FurkanTahaBademci/Tasarim_Kodlar_Elektromanyetik_Katapult/README.md

# Tasarim_Kodlar_Elektromanyetik_Katapult
