FurkanTahaBademci/Tasarim_Kodlar_Elektromanyetik_Katapult/Final Tasarım CAD/Teknik Resim.PNG

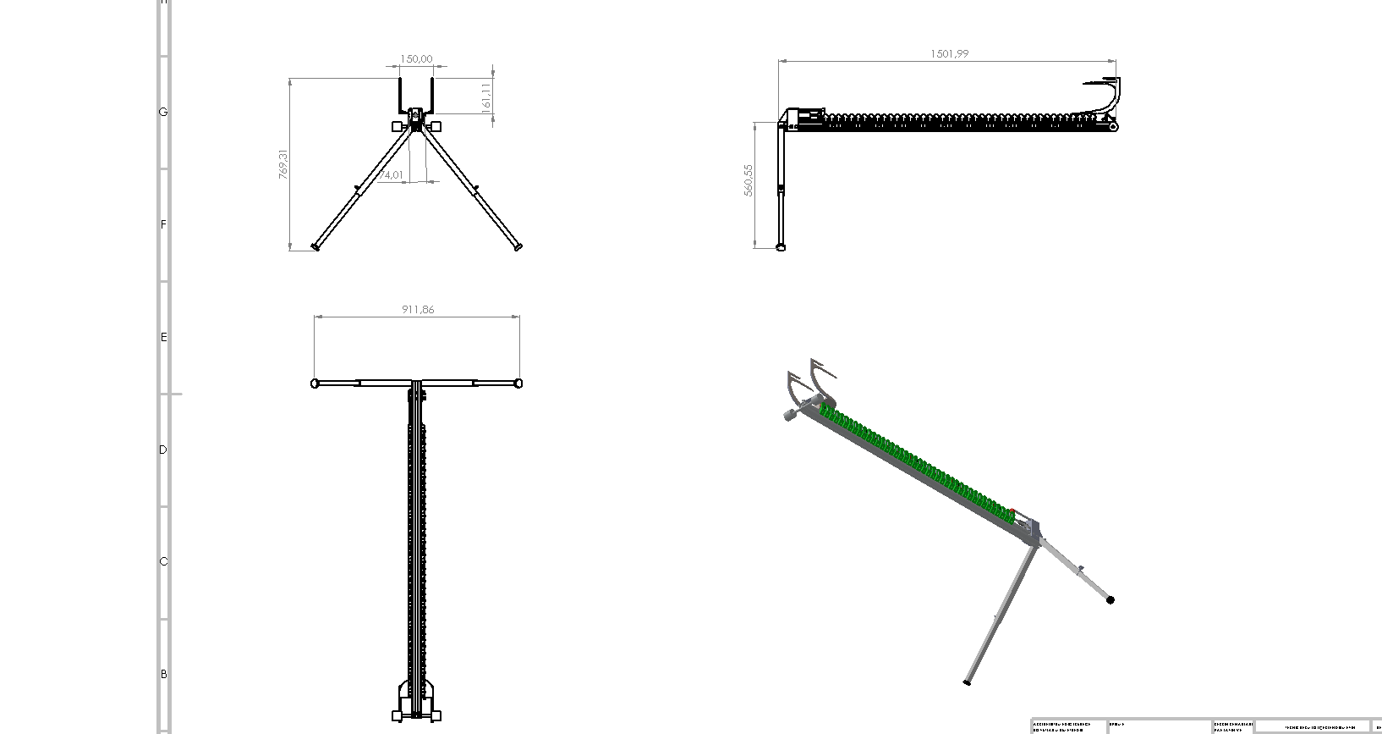
Final Tasarım CAD/Teknik Resim.PNG
