FurkanTahaBademci/Tasarim_Kodlar_Elektromanyetik_Katapult/Final Tasarım CAD/Kızak.sldasm

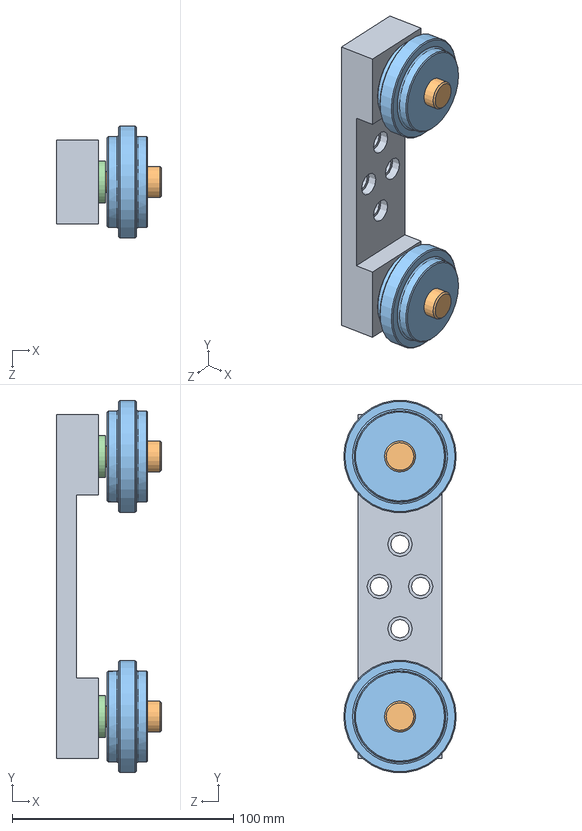
[picture p41: CAD file, 2025-01-13]
Final Tasarım CAD/Kızak.sldasm
47.6 x 168.0 x 50.8 mm
2757-1_b
2290_b x 2
2290_w x 2
2290_p2 x 2
