FurkanTahaBademci/Tasarim_Kodlar_Elektromanyetik_Katapult/Final Tasarım CAD/Bütünleşik Montaj.SLDASM

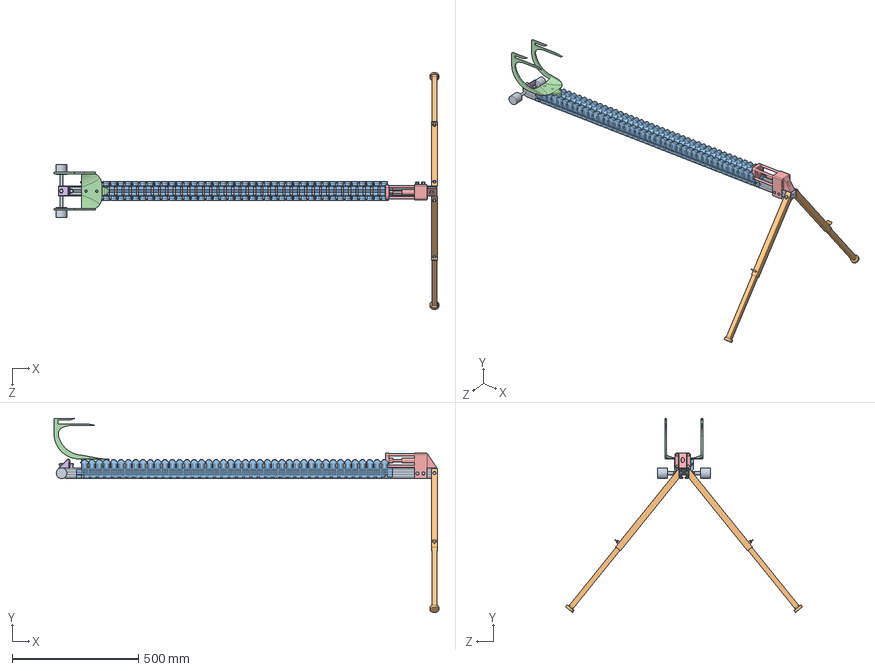
[picture p42: CAD file, 2025-01-13]
Final Tasarım CAD/Bütünleşik Montaj.SLDASM
1526.4 x 769.3 x 940.2 mm
Sigma Profil Ray
Teleskobik Ayak x 2
Bobin ve Bobin Yuvası x 84
Taşıma Platformu
Darbe Emici
optik_sensörü
