FurkanTahaBademci/Tasarim_Kodlar_Elektromanyetik_Katapult/Final Tasarım CAD/Sigma Profil Ray.SLDPRT

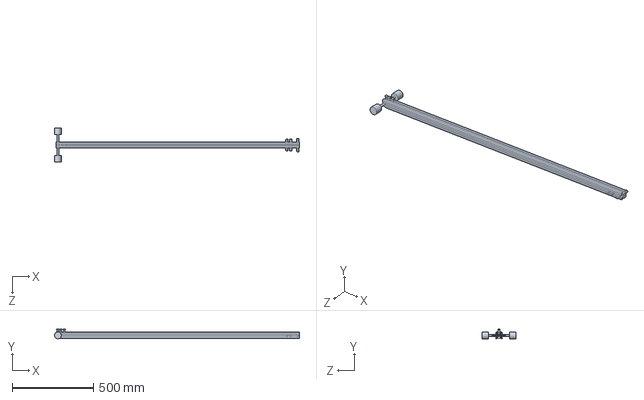
[picture p43: CAD file, 2025-01-13]
Final Tasarım CAD/Sigma Profil Ray.SLDPRT
1509.9 x 59.1 x 212.0 mm
