FurkanTahaBademci/Tasarim_Kodlar_Elektromanyetik_Katapult/Final Tasarım CAD/Taşıma Platformu.SLDPRT

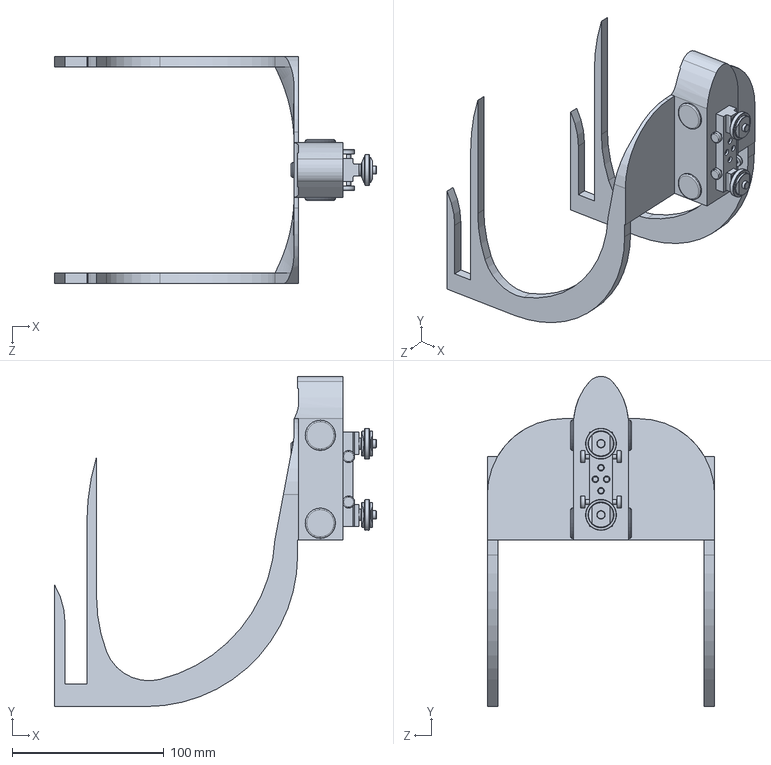
[picture p44: CAD file, 2025-01-13]
Final Tasarım CAD/Taşıma Platformu.SLDPRT
212.5 x 217.9 x 150.0 mm
