FurkanTahaBademci/Tasarim_Kodlar_Elektromanyetik_Katapult/Final Tasarım CAD/optik_sensörü.SLDPRT

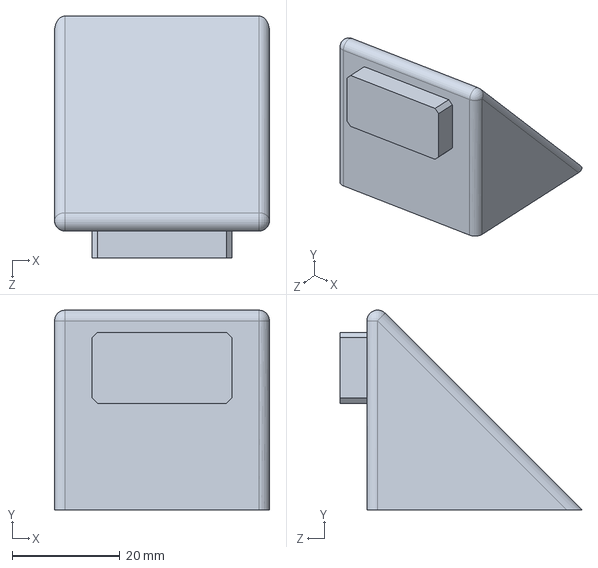
[picture p45: CAD file, 2025-01-13]
Final Tasarım CAD/optik_sensörü.SLDPRT
40.0 x 37.2 x 45.0 mm
