FurkanTahaBademci/Tasarim_Kodlar_Elektromanyetik_Katapult/Final Tasarım CAD/Teleskobik Ayak.SLDPRT

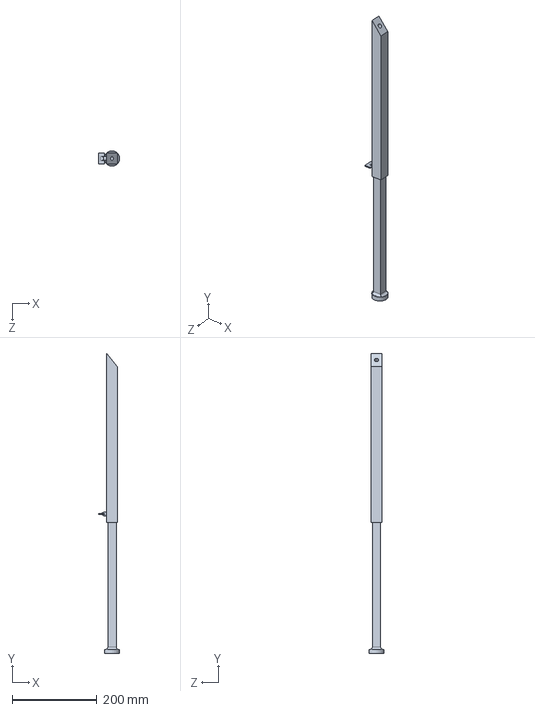
[picture p46: CAD file, 2025-01-13]
Final Tasarım CAD/Teleskobik Ayak.SLDPRT
50.7 x 710.0 x 36.3 mm
