FurkanTahaBademci/Tasarim_Kodlar_Elektromanyetik_Katapult/Final Tasarım CAD/Bobin ve Bobin Yuvası.SLDPRT

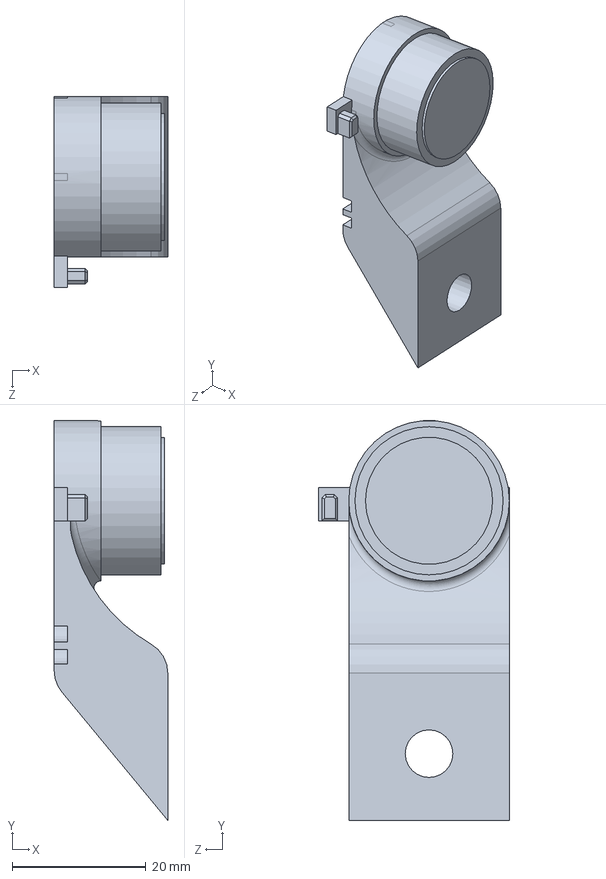
[picture p47: CAD file, 2025-01-13]
Final Tasarım CAD/Bobin ve Bobin Yuvası.SLDPRT
17.0 x 59.8 x 28.5 mm
