FurkanTahaBademci/Tasarim_Kodlar_Elektromanyetik_Katapult/Final Tasarım CAD/Darbe Emici.SLDPRT

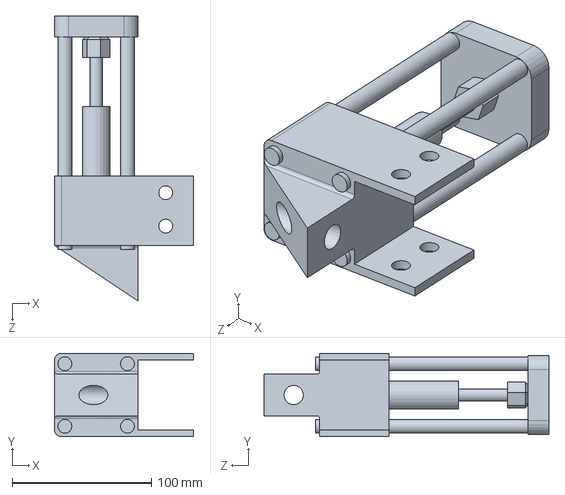
[picture p48: CAD file, 2025-01-13]
Final Tasarım CAD/Darbe Emici.SLDPRT
100.0 x 60.0 x 205.0 mm
