FurkanTahaBademci/Tasarim_Kodlar_Elektromanyetik_Katapult/(list of files, cad)

Other CAD files:
Final Tasarım CAD/Teknik Resim.SLDDRW
